jackbrad1ey/neptune_v2/neptune/local-library/SOIC-8-208MIL.stp

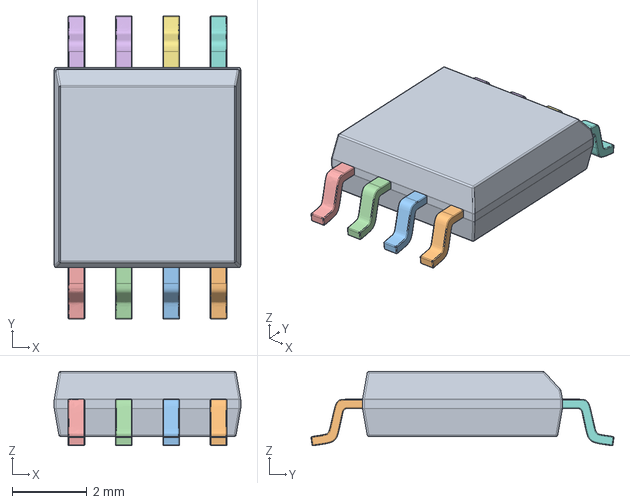
[picture p3: CAD file, 2023-06-30]
neptune/local-library/SOIC-8-208MIL.stp
5.00 x 8.12 x 2.00 mm
