jackbrad1ey/neptune_v2/neptune/local-library/micro_usb_connector.STEP

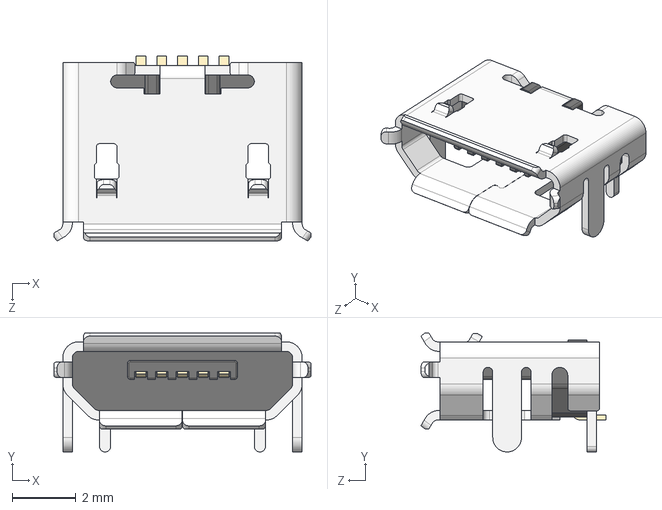
[picture p4: CAD file, 2023-06-30]
neptune/local-library/micro_usb_connector.STEP
8.05 x 3.73 x 5.80 mm
