jackbrad1ey/neptune_v2/neptune/local-library/IHLP2525.step

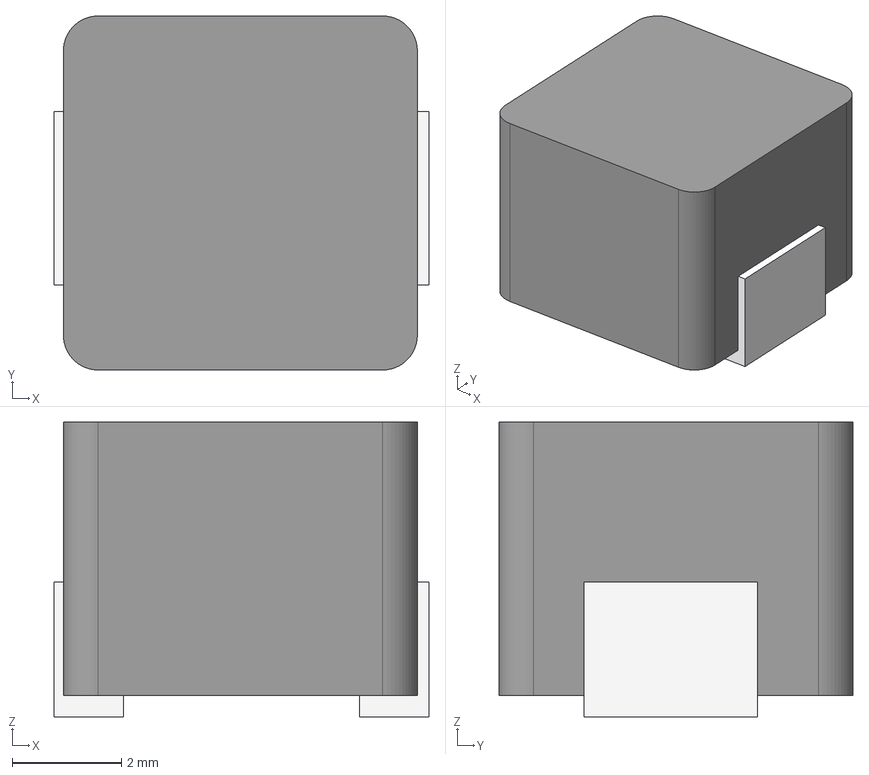
[picture p5: CAD file, 2023-06-30]
neptune/local-library/IHLP2525.step
6.86 x 6.48 x 5.39 mm
