jackbrad1ey/neptune_v2/neptune/local-library/BMX055.step

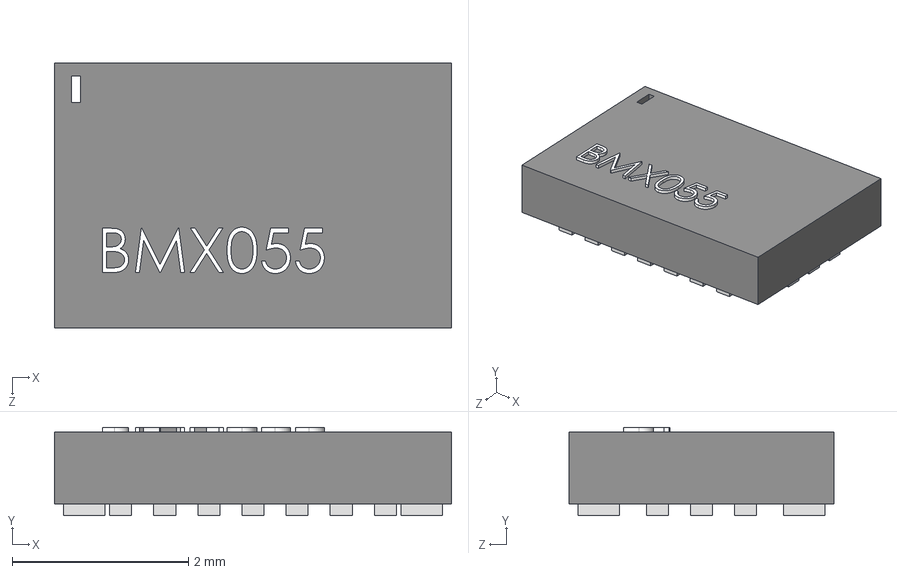
[picture p7: CAD file, 2023-06-30]
neptune/local-library/BMX055.step
4.50 x 1.00 x 3.00 mm
