jackbrad1ey/neptune_v2/neptune/local-library/SOP-8.STEP

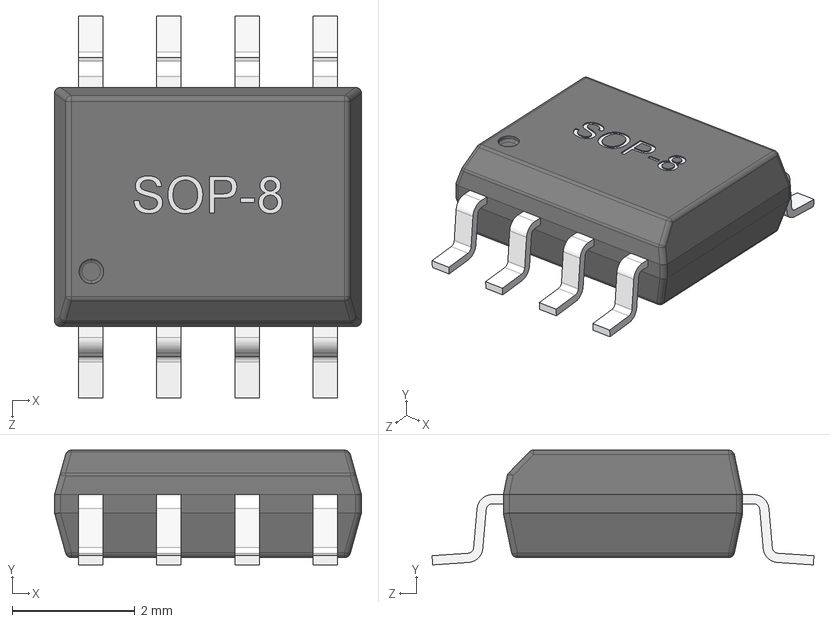
[picture p8: CAD file, 2023-06-30]
neptune/local-library/SOP-8.STEP
5.00 x 1.87 x 6.22 mm
