jackbrad1ey/neptune_v2/neptune/local-library/XT30PWM.step

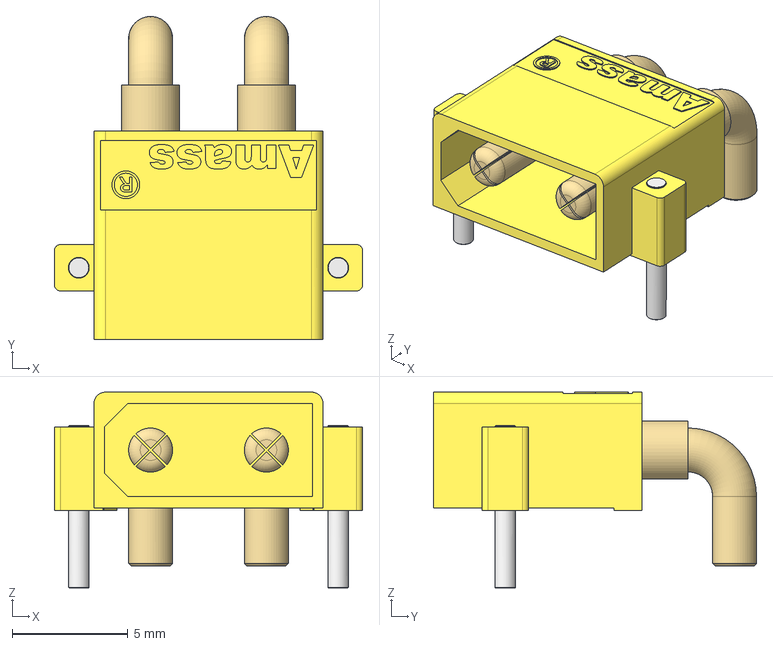
[picture p9: CAD file, 2023-06-30]
neptune/local-library/XT30PWM.step
13.3 x 13.9 x 8.45 mm
