jackbrad1ey/neptune_v2/neptune/local-library/radio_connector.STEP

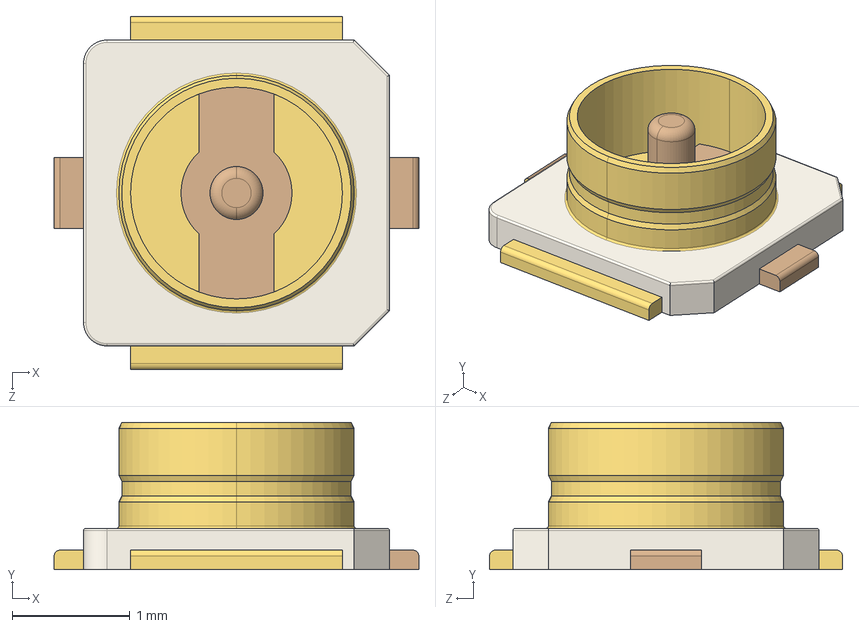
[picture p10: CAD file, 2023-06-30]
neptune/local-library/radio_connector.STEP
3.10 x 1.25 x 3.00 mm
