jackbrad1ey/neptune_v2/neptune/neptune.kicad_pcb

## KiCad design neptune/neptune.kicad_pcb (2023-06-30)

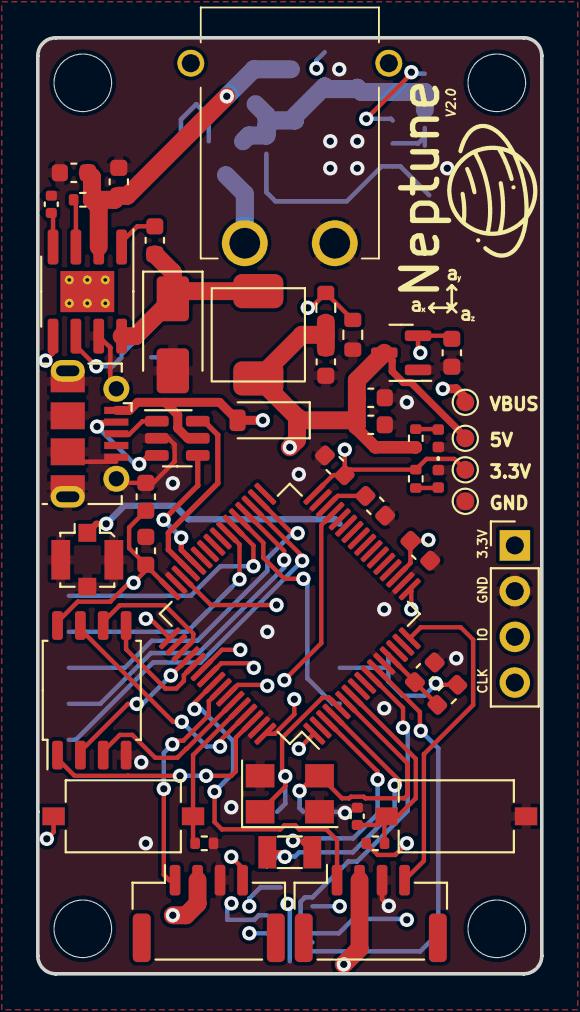
[picture p11: board neptune.kicad_pcb from above]

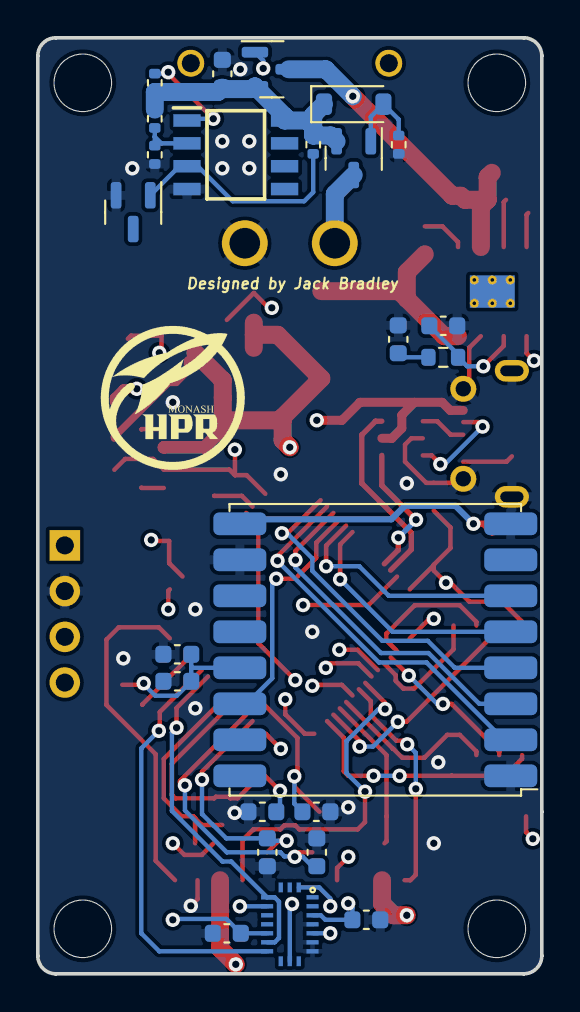
[picture p12: board neptune.kicad_pcb from below]

Board: 4 copper layers, 28.0 x 52.0 mm, 75 parts (24 on the bottom side), 57 nets.

Parts:
C1, C5, C8, C12, C13, C20, C21, C24, C25, C26: 100nF; C_0603_1608Metric
C2, C4, C11: 10u; C_0603_1608Metric
C3, C7, C22: 1u; C_0603_1608Metric
C6: 8.2n; C_0402_1005Metric
C9: 1n; C_0603_1608Metric
C10: 10p; C_0603_1608Metric
C14: 1u; C_0402_1005Metric
C15, C17: 33p; C_0603_1608Metric
C16, C18: 15p; C_0603_1608Metric
C19: 10n; C_0603_1608Metric
C23: 4.7u; C_0603_1608Metric
D1, D3: B5819W; D_SOD-123
D2: RB056LAM-40TR; D_SMA
D3#2, D5: LED; LED_0402_1005Metric
H1, H2, H3, H4: MountingHole; MountingHole_3.2mm_M3
J1: Conn_Coaxial; U.FL_Molex_MCRF_73412-0110_Vertical
J3: USB_B_Micro; USB_Micro-B_Molex-105017-0001
J4: Conn_01x02; XT30PWM
J5: Conn_01x04; PinHeader_1x04_P2.54mm_Vertical
J6, J7: Conn_01x04; JST_GH_SM04B-GHS-TB_1x04-1MP_P1.25mm_Horizontal
L1: IHLP2020CZER100M01
L2: 10u; L_0603_1608Metric
Q1: Si2301-TP; SOT-23
Q2: AO3401A; SOT-23
R1, R5: 100k; R_0402_1005Metric
R2, R4: 30k; R_0402_1005Metric
R3: 56k; R_0402_1005Metric
R6: NC; R_0402_1005Metric
R7: 36.5k; R_0603_1608Metric
R8: 10.2k; R_0603_1608Metric
R9: 1.91k; R_0603_1608Metric
R10, R11: 10k; R_0402_1005Metric
R10#2, R11#2: 200; R_0402_1005Metric
SW1, SW2: TS-1187A-B-A-B; SW_Tactile_SPST_NO_Straight_CK_PTS636Sx25SMTRLFS
TP1, TP2, TP3, TP4: TestPoint_Pad_D1.0mm
U1: ADR5040ARTZ-2.048; SOT-23
U2: LM393; SOIC127P600X175-8N
U3: TPS54331D; SOIC-8-1EP_3.9x4.9mm_P1.27mm_EP2.29x3mm_ThermalVias
U4: LP3993-33B3F; SOT-23
U5: RFM95W-915S2; HOPERF_RFM9XW_SMD
U6: STM32F411RETx; LQFP-64_10x10mm_P0.5mm
U7: BMX055
U8: USBLC6-2SC6; SOT-23-6
U10: AT25SF081-XMHF-X; SOP-8_5.28x5.23mm_P1.27mm
Y1: 12MHz; Crystal_SMD_5032-4Pin_5.0x3.2mm
Y2: 32.768k; Crystal_SMD_3215-2Pin_3.2x1.5mm

Connections:
+3V3: C7.1, C12.1, C13.1, C19.1, C20.1, C21.1, C22.1, C25.1, C26.1, J5.1, L2.1, R11.2, R11#2.1, SW1.2, TP4.1, U4.2 (VOUT), U5.13 (3.3V), U6.1 (VBAT), U6.19 (VDD), U6.32 (VDD), U6.48 (VDD), U6.64 (VDD), U7.3 (VDD), U7.13 (VDDIO), U10.8 (VCC)
+5V: C3.1, C5.1, C11.1, D3.1 (K), J6.2, J7.2, L1.2, R8.2, R10#2.1, TP2.1, U4.3 (VIN)
/Data management/CS_FC: U6.62 (PB9), U10.1 (~CS)
/Data management/CS_RF: U5.5 (NSS), U6.39 (PC8)
/Data management/HOLD_FC: U6.61 (PB8), U10.7 (~HOLD/IO3)
/Data management/MISO_FC: U6.52 (PC11), U10.2 (SO/IO1)
/Data management/MISO_RF: U5.2 (MISO), U6.35 (PB14)
/Data management/MOSI_FC: U6.53 (PC12), U10.5 (SI/IO0)
/Data management/MOSI_RF: U5.3 (MOSI), U6.36 (PB15)
/Data management/RESET_RF: U5.6 (RESET), U6.38 (PC7)
/Data management/RF_IO0: U5.14 (DIO0), U6.37 (PC6)
/Data management/SCK_FC: U6.51 (PC10), U10.6 (SCK)
/Data management/SCK_RF: U5.4 (SCK), U6.34 (PB13)
/Data management/WP_FC: U6.59 (PB7), U10.3 (~WP/IO2)
/Power/BATT: J4.1, Q1.3 (D)
/STM32/BOOT0: R10.2, SW1.1, U6.60 (BOOT0)
/STM32/CE_ACC: U6.58 (PB6), U7.16 (CSB1)
/STM32/CE_GYR: U6.55 (PB3), U7.5 (CSB2)
/STM32/CE_MAG: U6.54 (PD2), U7.20 (CSB3)
/STM32/IMU_MISO: U6.10 (PC2), U7.12 (SDO2), U7.17 (SDO1)
/STM32/IMU_MOSI: U6.11 (PC3), U7.11 (SDX)
/STM32/IMU_SCK: U6.29 (PB10), U7.9 (SCX)
/STM32/NRST: C14.1, R11.1, SW2.2, U6.7 (NRST)
/STM32/OSC32_IN: C16.1, U6.3 (PC14), Y2.1
/STM32/OSC32_OUT: C18.1, U6.4 (PC15), Y2.2
/STM32/OSC_IN: C15.1, U6.5 (PH0), Y1.1
/STM32/OSC_OUT: C17.1, U6.6 (PH1), Y1.3
/STM32/S1_control: J6.1, U6.56 (PB4)
/STM32/S1_feedback: J6.4, U6.16 (PA2)
/STM32/S2_control: J7.1, U6.57 (PB5)
/STM32/S2_feedback: J7.4, U6.17 (PA3)
/STM32/SWCLK: J5.4, U6.49 (PA14)
/STM32/SWDIO: J5.3, U6.46 (PA13)
/STM32/USB_D+: U6.45 (PA12), U8.6 (I/O1)
/STM32/USB_D-: U6.44 (PA11), U8.4 (I/O2)
GND: C1.2, C2.2, C3.2, C4.2, C5.2, C6.2, C7.2, C9.2, C10.2, C11.2, C12.2, C13.2, C14.2, C15.2, C16.2, C17.2, C18.2, C19.2, C20.2, C21.2, C22.2, C23.2, C24.2, C25.2, C26.2, D2.2 (A), D3#2.1 (K), D5.1 (K), J1.2 (Ext), J3.5 (GND), J3.6 (Shield), J4.2, J5.2, J6.3, J7.3, R1.1, R4.1, R9.1, R10.1, SW2.1, TP3.1, U1.2 (A), U2.4 (V-), U3.7 (GND), U4.1 (GND), U5.1 (GND), U5.8 (GND), U5.10 (GND), U6.12 (VSSA), U6.18 (VSS), U6.31 (VSS), U6.47 (VSS), U6.63 (VSS), U7.4 (GNDA), U7.6 (GNDIO), U7.7 (PS), U8.2 (GND), U10.4 (GND), Y1.2, Y1.4
unnamed: C9.1, R7.1
unnamed: D1.2 (A), Q1.1 (G), R1.2
unnamed: C8.2, D2.1 (K), L1.1, U3.8 (PH)
unnamed: D3#2.2 (A), R10#2.2
unnamed: D5.2 (A), R11#2.2
unnamed: J1.1 (In), U5.9 (ANT)
unnamed: J3.3 (D+), U8.1 (I/O1)
unnamed: J3.2 (D-), U8.3 (I/O2)
unnamed: Q2.1 (G), R5.1, U2.1
unnamed: R2.1, U1.1 (K), U2.3 (+)
unnamed: R3.1, R4.2, U2.2 (-)
unnamed: C8.1, U3.1 (BOOT)
unnamed: C10.1, R7.2, U3.6 (COMP)
unnamed: R6.1, U3.3 (EN)
unnamed: C6.1, U3.4 (SS)
unnamed: R8.1, R9.2, U3.5 (VSENSE)
unnamed: C23.1, U6.30 (VCAP1)
unnamed: C24.1, L2.2, U6.13 (VDDA)
VBUS: D3.2 (A), J3.1 (VBUS), TP1.1, U8.5 (VBUS)
VCC: C2.1, C4.1, Q2.3 (D), R6.2, U3.2 (VIN)
VDC: C1.1, D1.1 (K), Q1.2 (S), Q2.2 (S), R2.2, R3.2, R5.2, U2.8 (V+)
