jackbrad1ey/neptune_v2/(commit log)

2023-06-30 Modified schematic, started routing
    [STM32.kicad_sch, Sensors.kicad_sch, connections.kicad_sch, data_management.kicad_sch, neptune.kicad_pcb, neptune.kicad_sch, power.kicad_sch]
2023-06-30 Updated some footprints, restarted routing
    [STM32.kicad_sch, connections.kicad_sch, data_management.kicad_sch, neptune.kicad_pcb, neptune.kicad_sch]
2023-06-30 Continued routing
    [STM32.kicad_sch, connections.kicad_sch, data_management.kicad_sch, neptune.kicad_pcb, neptune.kicad_sch, power.kicad_sch]
2023-06-30 Routed 3.3V stepdown, added indicator LEDs
    [STM32.kicad_sch, Sensors.kicad_sch, connections.kicad_sch, data_management.kicad_sch, neptune.kicad_pcb, power.kicad_sch]
2023-06-30 Finished routing
    [neptune.kicad_pcb, neptune.kicad_sch, power.kicad_sch]
2023-06-30 Moved USB slightly, added 3D models
    [BMX055.step, IHLP2525.step, RFM95W.step, SOIC-8-208MIL.stp, SOP-8.STEP, XT30PWM.step, micro_usb_connector.STEP, neptune.kicad_pcb]
2023-06-30 Small change
    [neptune.kicad_pcb]
